ramibelsito/TP1_Embebidos/ArbolDeProyecto.jpeg

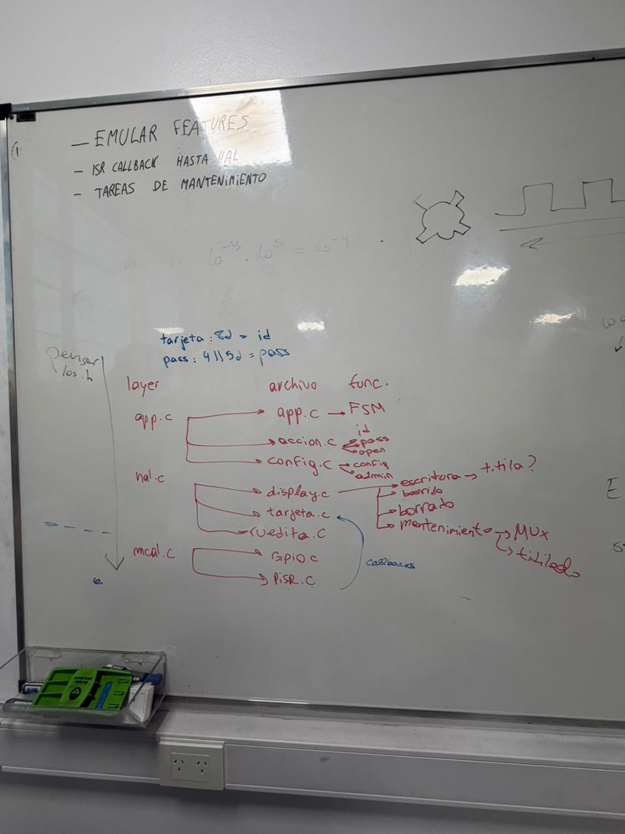
ArbolDeProyecto.jpeg
