ramibelsito/TP1_Embebidos/README.md

# TP1_Embebidos
Control de Acceso Mediante Tarjeta Magnética

## ToDoList
 
 1. Hacer la lógica para leer y procesar los datos de la tarjeta
 2. Terminar el driver del Display
 3. Organizar manejo de usuarios
 4. Hacer FSM General
 5. Terminar App
