ramibelsito/TP1_Embebidos/ManualDeUsuario_G4.pdf

## Guía de Usuario: Sistema de Control de Acceso

Grupo 4

Integrantes:
Ramiro Belsito, Franco Morroni, Iñaki Alonso Guarrochena, Joaquin Gomez

13 de abril de 2026

## 1. Introducción

Este documento detalla el funcionamiento y la interfaz de usuario del sistema de gestión de puertas. El control se realiza mediante un encoder rotativo (con pulsador) y un lector de tarjeta magnética.

## 2. Glosario de Pantalla e Indicadores

Para facilitar la navegación, el sistema utiliza los siguientes códigos visuales en el display de 7 segmentos y LEDs:

- Dígito Parpadeante: Indica que el sistema está en Modo Selección. Al girar el encoder, se moverá el cursor entre los distintos dígitos.
- Dígito Estable con Punto Decimal: Indica que el sistema está en Modo Edición. Al girar el encoder, se cambiará el valor numérico del dígito actual.
- Mensaje ID INVALID: El número de identificación ingresado no se encuentra en la base de datos. El sistema regresará al inicio.
- Mensaje BAD PASS: La clave ingresada es incorrecta para el ID proporcionado. Por seguridad, se debe reingresar el ID desde el principio.
- LEDs Rojos (1 y 3): Su encendido indica que el pestillo eléctrico ha sido liberado satisfactoriamente, permanece liberado por unos 5 segundos.

### 2.1. Pantalla de Inicio (Estado IDLE)

Al iniciar el programa, el sistema se encuentra en espera. Las acciones disponibles son:

- Un clic: Proceder al ingreso de ID de forma manual.
- Doble clic: Ajuste de intensidad de pantalla. Se mostrarán ceros en el display; gire el encoder para alterar el brillo. Para confirmar y volver al inicio, realice un doble clic nuevamente.
- Pasar tarjeta: El sistema guarda el ID leído. El mismo será comprobado automáticamente al avanzar al siguiente estado.

### 2.2. Ingreso de ID

En este estado se identifica al usuario. Se puede realizar de dos formas:

- Automático: Al pasar la tarjeta, el sistema valida el ID. Si existe, avanza al ingreso de contraseña; de lo contrario, indica “ID inválido” y regresa al inicio.
- Manual con Encoder:
- Giro del encoder: Desplaza la selección hacia la izquierda o derecha.
- Un clic: Alterna entre Modo Selección (el dígito parpadea) y Modo Edición (el punto decimal del display se enciende para indicar que se puede cambiar el valor).
- Doble clic: Finaliza la edición manual y comprueba el ID.
- Mantener pulsado: Cancela la operación y vuelve a la pantalla inicial.

### 2.3. Ingreso de Clave (PIN)

La lógica de escritura es similar a la del ID, pero con las siguientes particularidades específicas del PIN:

Privacidad: Solo se muestra en pantalla el dígito que se está editando. Los demás se representan mediante una secuencia de guiones alternados (-_-_-) que oscila para indicar la posición actual y ocultar el resto de la contraseña. Los guiones van apareciendo a medida que se va escribiendo la contraseña.

Visualización dinámica: La alternancia entre guion alto y guion bajo señala el dígito activo. El parpadeo sirve como cursor y distingue si se está editando uno de los primeros cuatro dígitos o el quinto (en caso de contraseñas largas).

Longitud permitida: El sistema acepta contraseñas de 4 o 5 dígitos. Cuando el usuario selecciona 5 dígitos, la clave se considera una entrada diferente a la de 4 dígitos, incluso si comparten los primeros cuatro números.

## 3. Validación y Acceso

Si la contraseña es correcta, se encenderán dos LEDs rojos durante 5 segundos, simulando la apertura del pestillo eléctrico. En caso de error, el sistema regresará a la pantalla inicial por motivos de seguridad, obligando al usuario a reingresar el ID.

## 4. Especificaciones de los Controles

El sistema interpreta las acciones físicas sobre el encoder según los tiempos y la dirección de giro detallados a continuación. Cada salto físico de la perilla (tick) se procesa como una entrada individual.

Componente | Acción / Input
Pulsador | Clic Sostenido (Hold) Doble Clic (Ventana máx.) Clic Simple (Debounce)
Rotación | Giro Horario (CW) Giro Antihorario (CCW)

Cuadro 1: Especificaciones técnicas de los inputs del Encoder

Detalle de navegación por giro

- En modo Selección: Un tick desplaza el foco al siguiente dígito del display (8 posiciones para ID, 5 para PIN).
- En modo Edición: Un tick incrementa o decrementa el valor numérico (0 − 9) del dígito seleccionado actualmente.
