ramibelsito/TP1_Embebidos/placa/placa-F_Mask.pdf

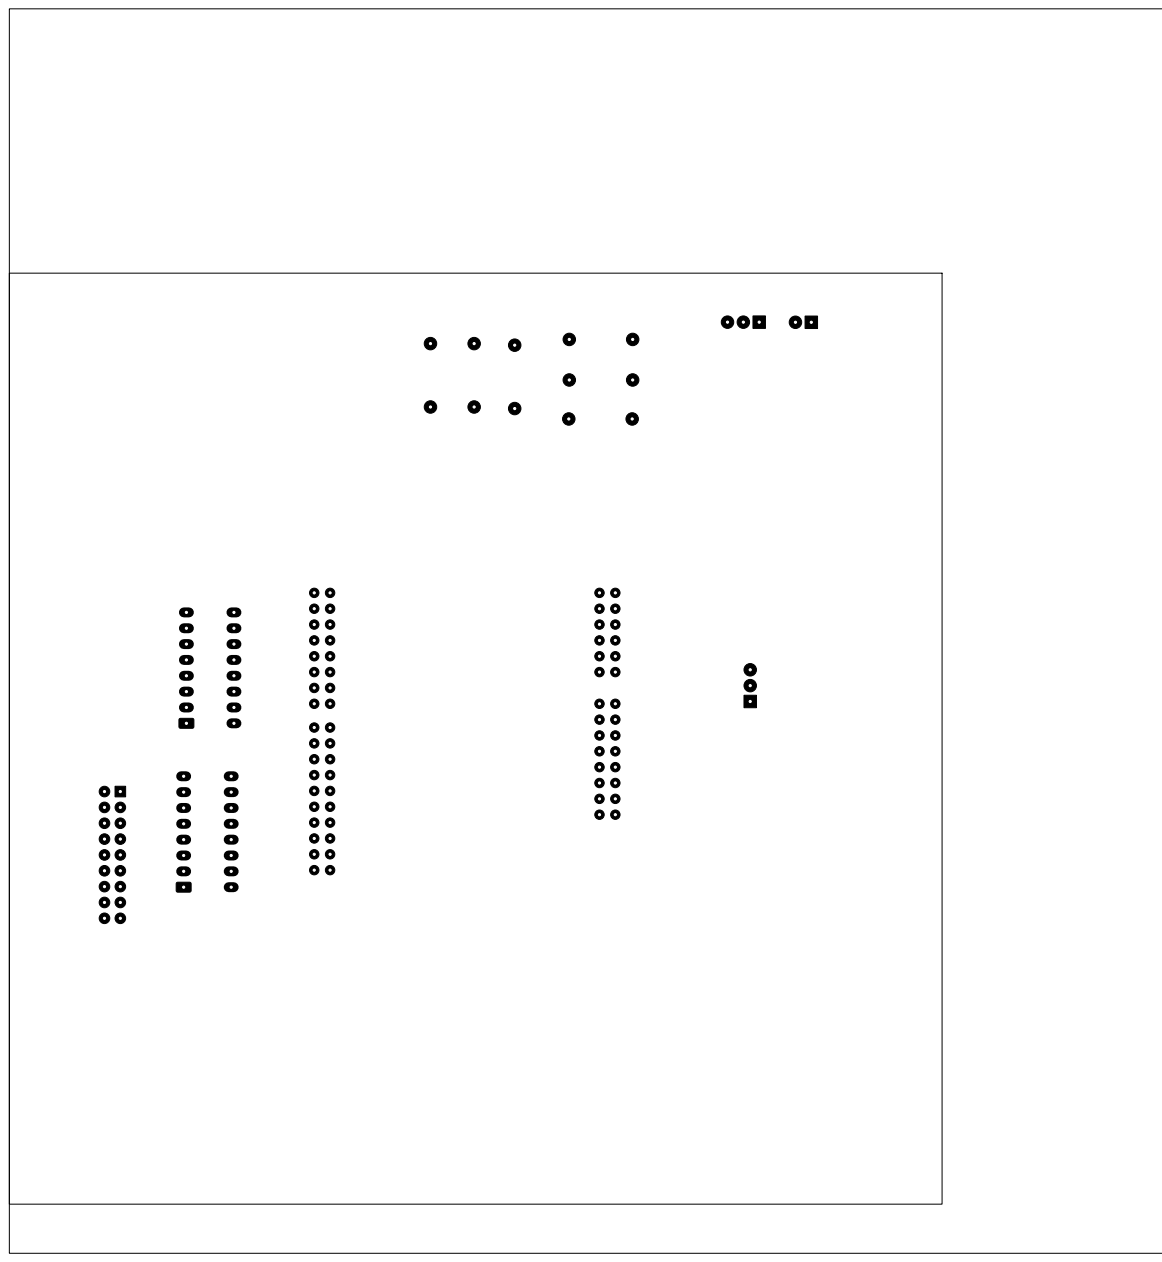
[picture p4: page 1]
