ramibelsito/TP1_Embebidos/placa/placa-F_Silkscreen.pdf

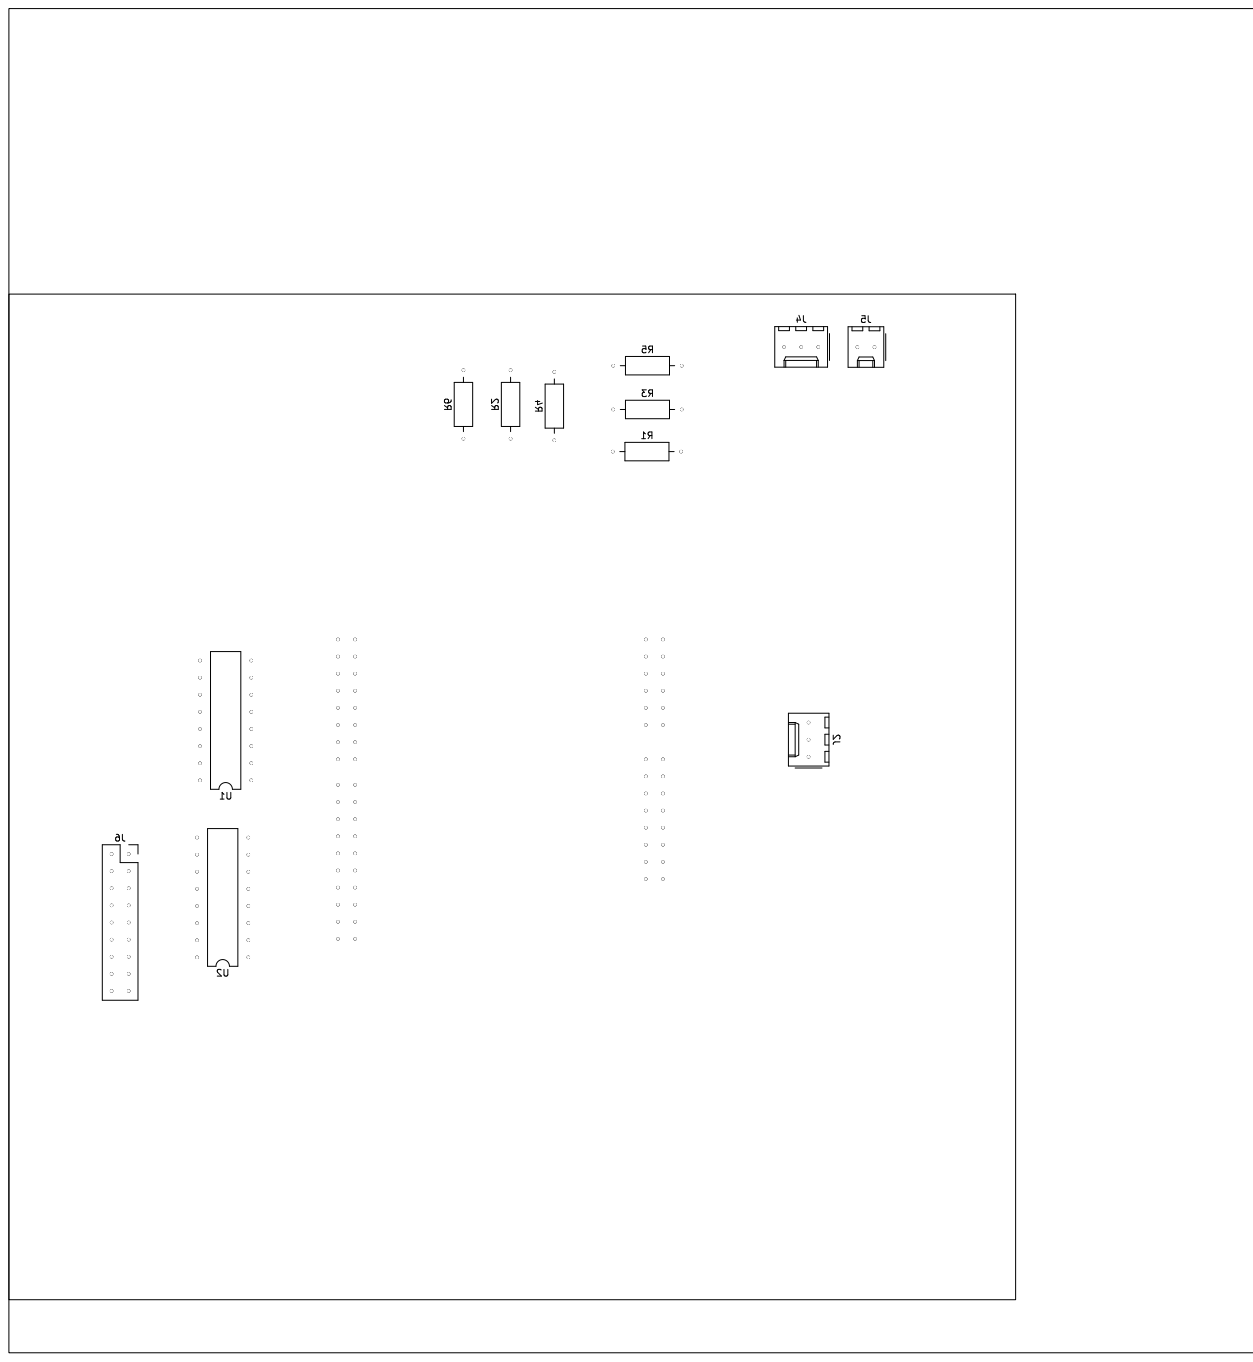
[picture p5: page 1]
