ramibelsito/TP1_Embebidos/placa/Plano de masas.pdf

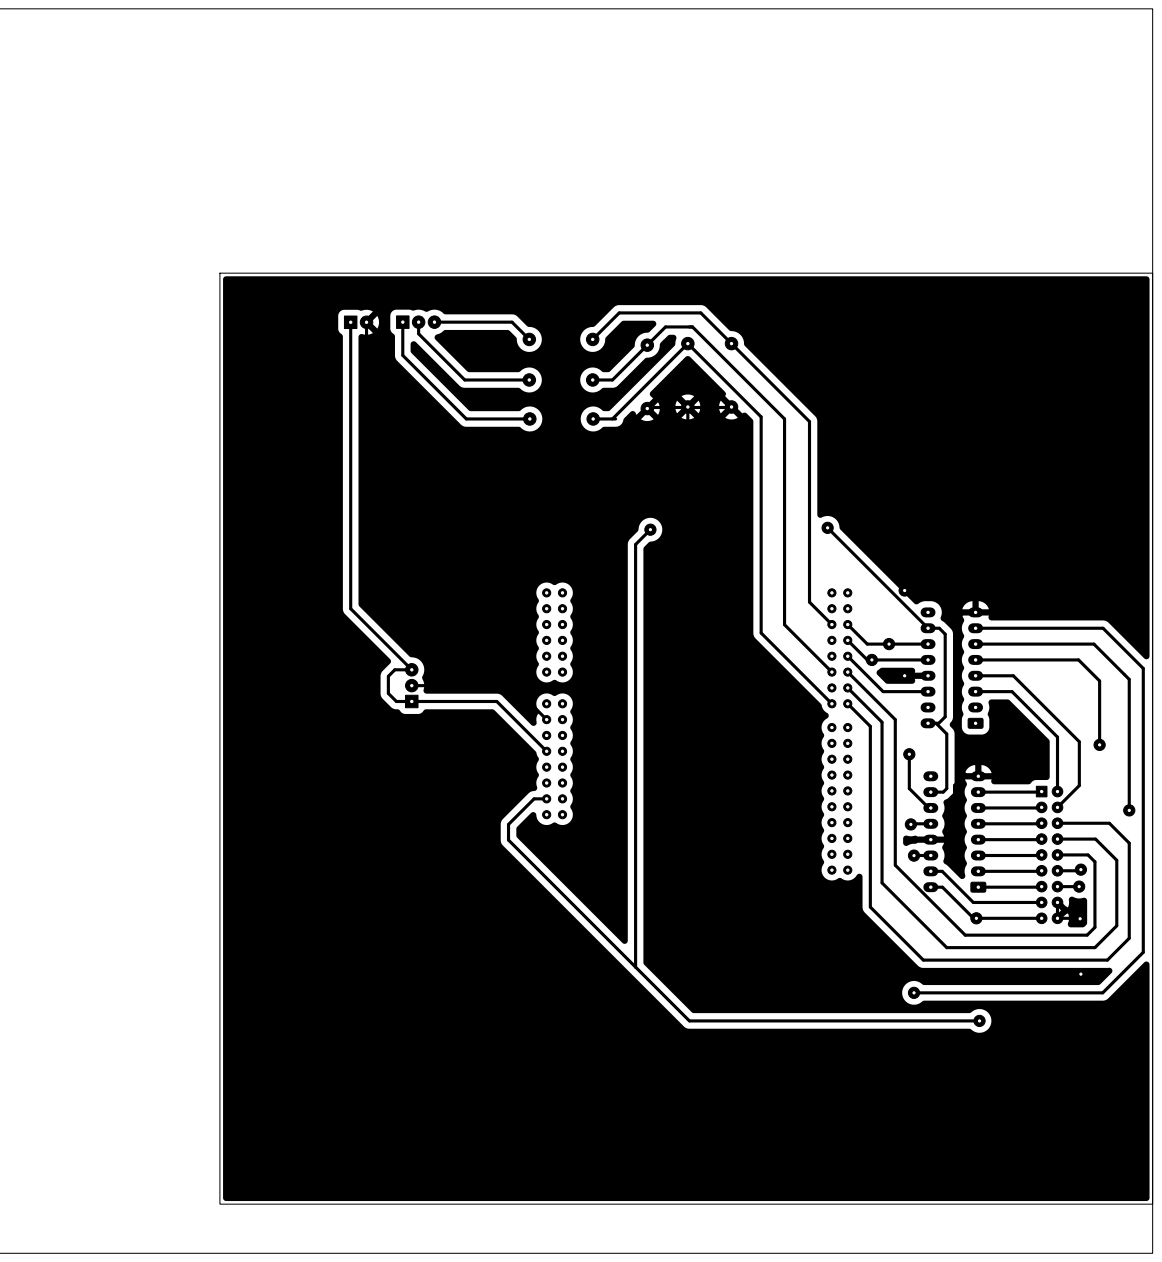
[picture p6: page 1]
