ramibelsito/TP1_Embebidos/placa/placa.kicad_pcb

## KiCad design placa/placa.kicad_pcb (2026-04-13)

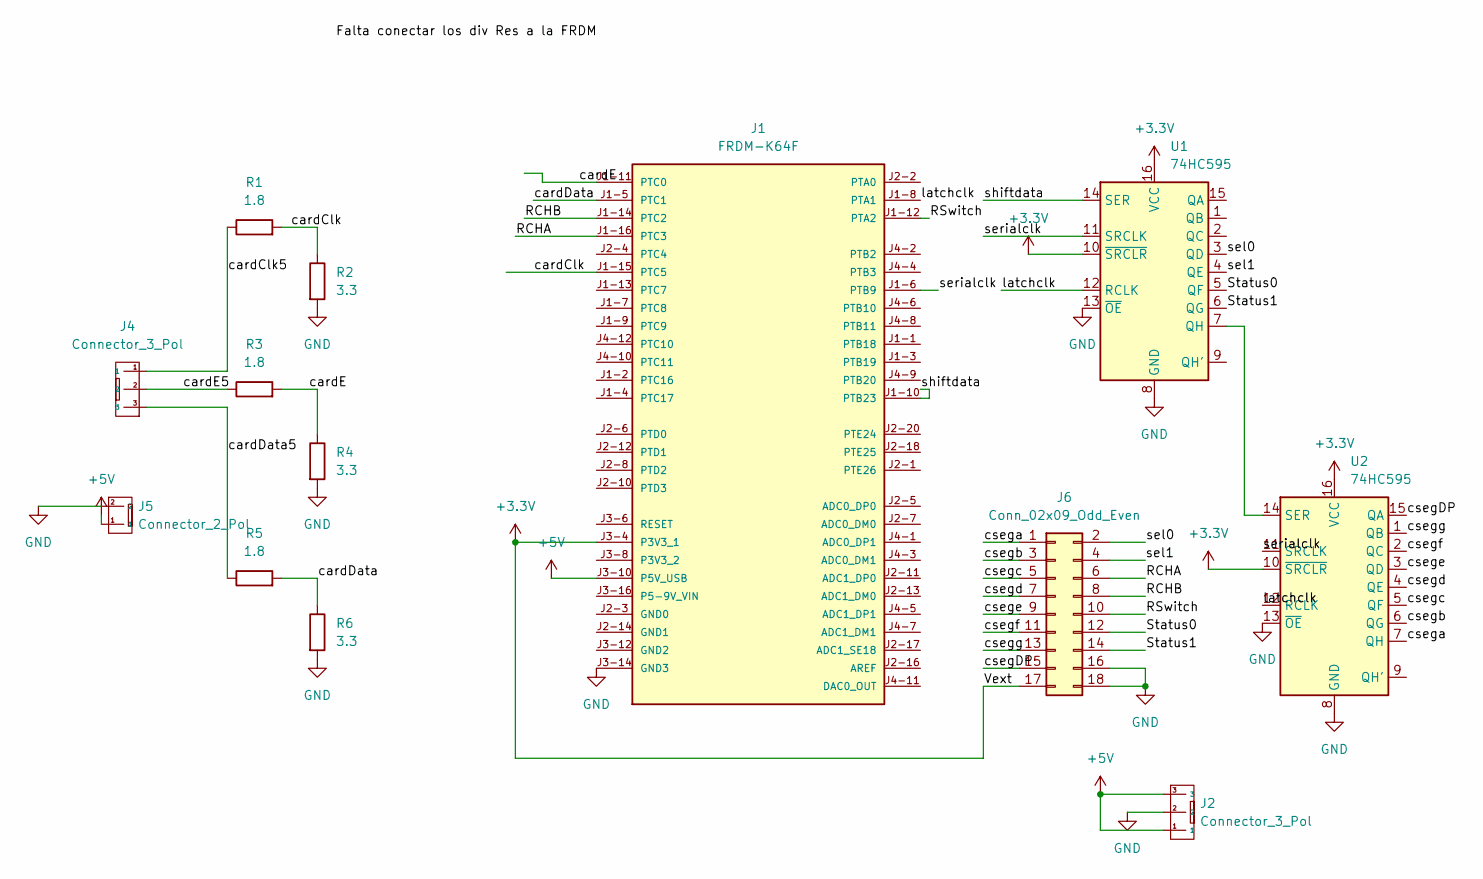
[picture p7: schematic placa.kicad_sch]

Parts:
J1: FRDM-K64F
J2, J4: Connector_3_Pol; Molex_1x03_P2.54mm
J5: Connector_2_Pol; Molex_1x02_P2.54mm
J6: Conn_02x09_Odd_Even; PinHeader_2x09_P2.54mm_Vertical
R1, R3, R5: 1.8; R_0.25W
R2, R4, R6: 3.3; R_0.25W
U1, U2: 74HC595; DIP-16_W7.62mm_LongPads

Connections:
+3.3V: J1.J3-4 (P3V3_1), J6.17, U1.10 (~SRCLR), U1.16 (VCC), U2.10 (~SRCLR), U2.16 (VCC)
+5V: J1.J3-10 (P5V_USB), J2.1, J2.3, J5.1
/RCHA: J1.J1-16 (PTC3), J6.6
/RCHB: J1.J1-14 (PTC2), J6.8
/RSwitch: J1.J1-12 (PTA2), J6.10
/Status0: J6.12, U1.5 (QF)
/Status1: J6.14, U1.6 (QG)
/cardClk: J1.J1-15 (PTC5), R1.2, R2.1
/cardClk5: J4.1, R1.1
/cardData: J1.J1-5 (PTC1), R5.2, R6.1
/cardData5: J4.3, R5.1
/cardE: J1.J1-11 (PTC0), R3.2, R4.1
/cardE5: J4.2, R3.1
/csegDP: J6.15, U2.15 (QA)
/csega: J6.1, U2.7 (QH)
/csegb: J6.3, U2.6 (QG)
/csegc: J6.5, U2.5 (QF)
/csegd: J6.7, U2.4 (QE)
/csege: J6.9, U2.3 (QD)
/csegf: J6.11, U2.2 (QC)
/csegg: J6.13, U2.1 (QB)
/latchclk: J1.J1-8 (PTA1), U1.12 (RCLK), U2.12 (RCLK)
/sel0: J6.2, U1.3 (QD)
/sel1: J6.4, U1.4 (QE)
/serialclk: J1.J1-6 (PTB9), U1.11 (SRCLK), U2.11 (SRCLK)
/shiftdata: J1.J1-10 (PTB23), U1.14 (SER)
GND: J1.J3-14 (GND3), J2.2, J5.2, J6.16, J6.18, R2.2, R4.2, R6.2, U1.8 (GND), U1.13 (~OE), U2.8 (GND), U2.13 (~OE)
unnamed: U1.7 (QH), U2.14 (SER)

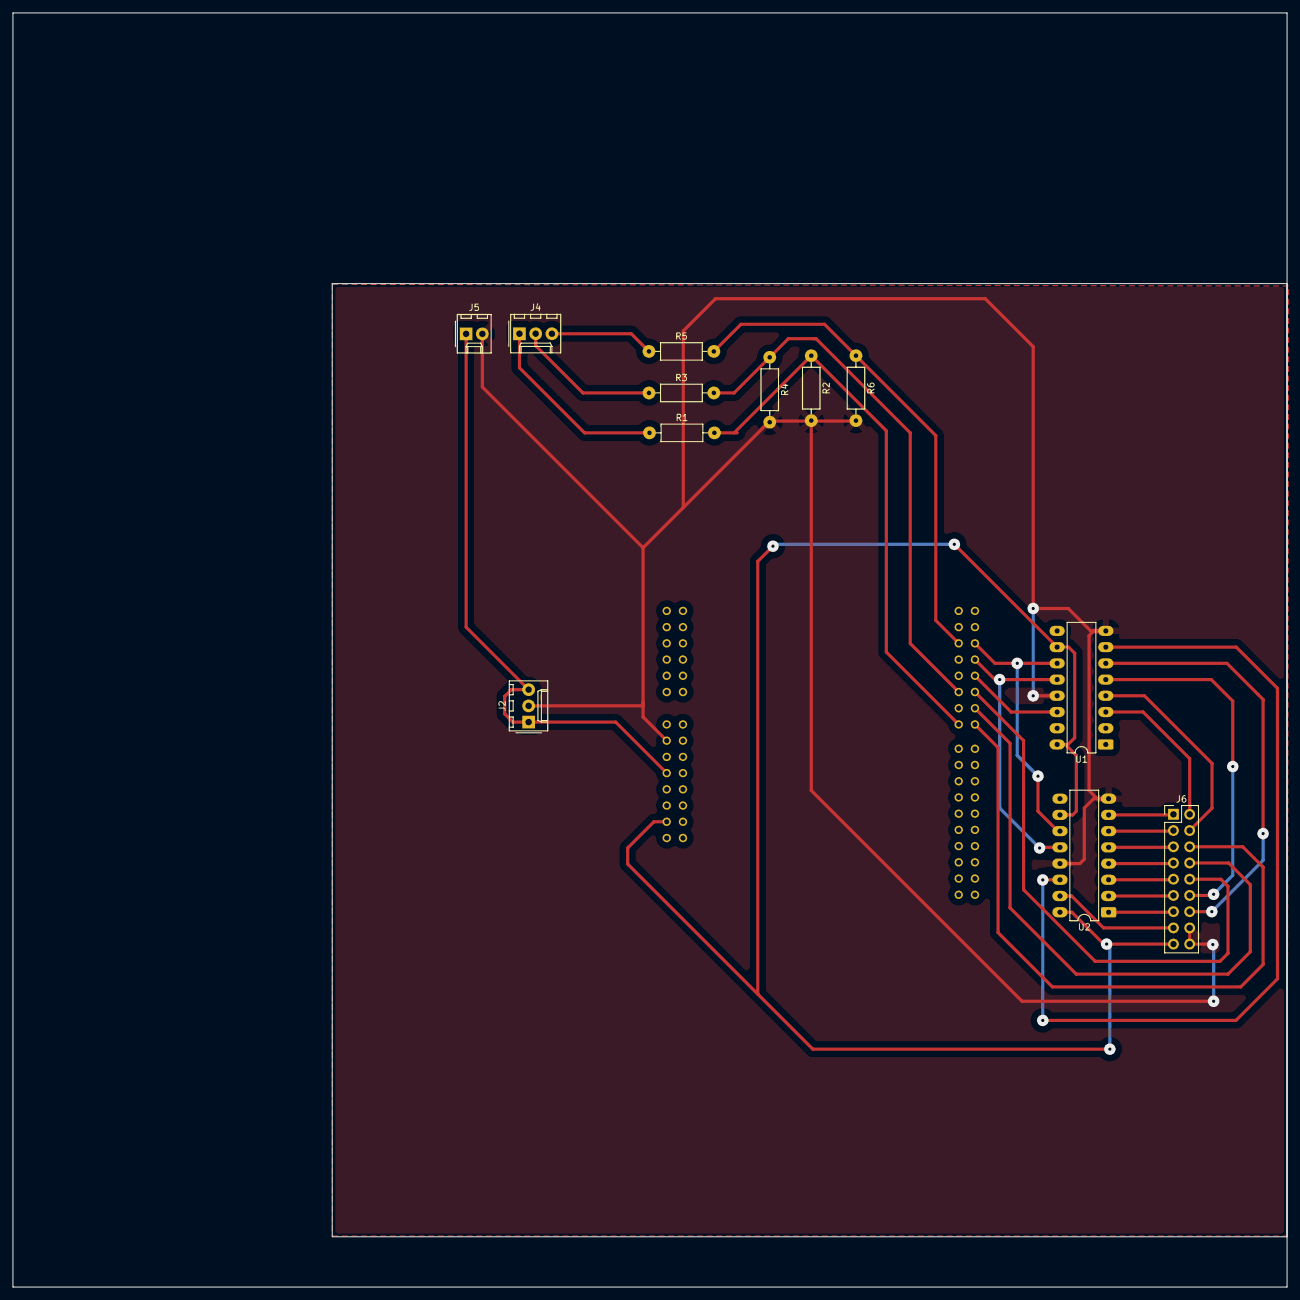
[picture p8: board placa.kicad_pcb from above]

Board: 2 copper layers, 199.5 x 199.5 mm, 13 parts (1 on the bottom side), 28 nets.
