ramibelsito/TP1_Embebidos/Codigo/source/hal/shift.c

#include "hal/shift.h"
#include "mcal/gpio.h"
#include <stdint.h>
#include "hal/board.h"
#include "hal/IRQN_Ports.h"


#define OUTCANT 16

static uint16_t shiftRegister = 0;

uint16_t shiftRead() {
  return shiftRegister;
}

void shiftWriteWord(uint16_t value) {
  shiftRegister = value;
  return;
}

void shiftWriteBit(int index, bool state) {
  if (state) shiftRegister |= (1 << index);
  else shiftRegister &= ~(1 << index);
  return;
}

bool shiftOutUpdate() {
  // TODO: averiguar si se puede hacer más eficiente con SPI.
  for (int i = 0; i < 16; i++) {
    gpioWrite(PIN_SHIFT, (shiftRegister >> i) & 1);
    gpioWrite(PIN_CLK, 1);
    gpioWrite(PIN_CLK, 0);
  }

  gpioWrite(PIN_SETOUT, 1);
  gpioWrite(PIN_SETOUT, 0);

  // TODO: should handle errors?
  return true;
}

bool shiftInit() {
  gpioInit(PIN_SHIFT);
  gpioMode(PIN_SHIFT, OUTPUT);
  gpioInit(PIN_CLK);
  gpioMode(PIN_CLK, OUTPUT);
  gpioWrite(PIN_CLK, 0);
  gpioInit(PIN_SETOUT);
  gpioMode(PIN_SETOUT, OUTPUT);
  gpioWrite(PIN_SETOUT, 0);

  // TODO: should handle errors?
  return true;
}
