ramibelsito/TP1_Embebidos/Codigo/source/hal/timers.h

#ifndef _TIMER_H_
#define _TIMER_H_

#include <stdbool.h>
#include <stdint.h>

// typedef struct TIMER {
//   uint32_t timerID;
//   uint32_t timerTarget; // Seconds
//   bool timerRing;
// } timer_t;

typedef struct TIMER {
  uint32_t durationMillis;
  uint64_t startMillis;
  bool started;
} timer_t;

void initTimers();
timer_t timerCreate(uint32_t durationMillis);
void timerStart(timer_t* timer);
bool timerFinished(timer_t* timer);

#endif // _TIMER_H_
