ramibelsito/TP1_Embebidos/Codigo/source/hal/card.h

#ifndef _CARD_H_
#define _CARD_H_
#include <stdbool.h>
#include <stdint.h>


#define CARD_TIMEOUT_MS    50*50*50

// Initializes the card reader driver
bool cardInit(void);

// Returns if cardData is ready
bool cardAvailable(void);

// Calls processBuffer() to process all buffer data when app needs it
void processCardData(void);

// Returns last card read
uint32_t cardRead(char *pId);

#endif // _CARD_H_
