ramibelsito/TP1_Embebidos/(commit log)

2026-04-01 Todo list y organización de archivos
2026-04-02 pisr logic for various periodic interruptions
2026-04-03 Arbol de funciones target armado
2026-04-04 Avance en encoder wheel.c
2026-04-06 Encoder casi funcando
2026-04-08 No se porque se habia modificado el wheel.c
2026-04-09 chore(shift): fix errors and refactor to use uin16_t instead of bool[16]
    [shift.c, shift.h]
2026-04-09 agregue una capa de leds y el encoder funciona joya
2026-04-09 agregue leds y el encoder funciona joya
2026-04-09 Se esta cumpliendo el interrupt de la tarjeta, falta logica
2026-04-10 Falta testear la logica
2026-04-10 Agrego la consigna
2026-04-11 Procesamiento de la data de la tarjeta. Falta testear
2026-04-11 Procesamiento del lector de tarjetas testeado
2026-04-11 reescribi los pines tal como la placa al board.h
2026-04-12 casi funciona tarjeta. Falla a la tercera lectura
2026-04-13 Funciona joya display
    [placa.kicad_pcb, placa.kicad_sch]
2026-04-13 Funciona correctamente el ingreso de id por tarjeta
    [card.c, card.h, display.c]
2026-04-13 feat: display led handling
2026-04-13 fix: variable declaration inside case without braces
2026-04-13 feat: timers
2026-04-13 fix: timers
2026-04-13 Tasa de refresco display mas rapida, sino parpadeaba y no cambiaba la intensidad bien
2026-04-13 Manual de referencia
2026-04-13 feat: pass change + more timers
2026-04-14 Manual de usuario
